Nandorroloco/SkyNando/WiFi version/pictures/IMG_20201117_204610 (957x1280).jpg

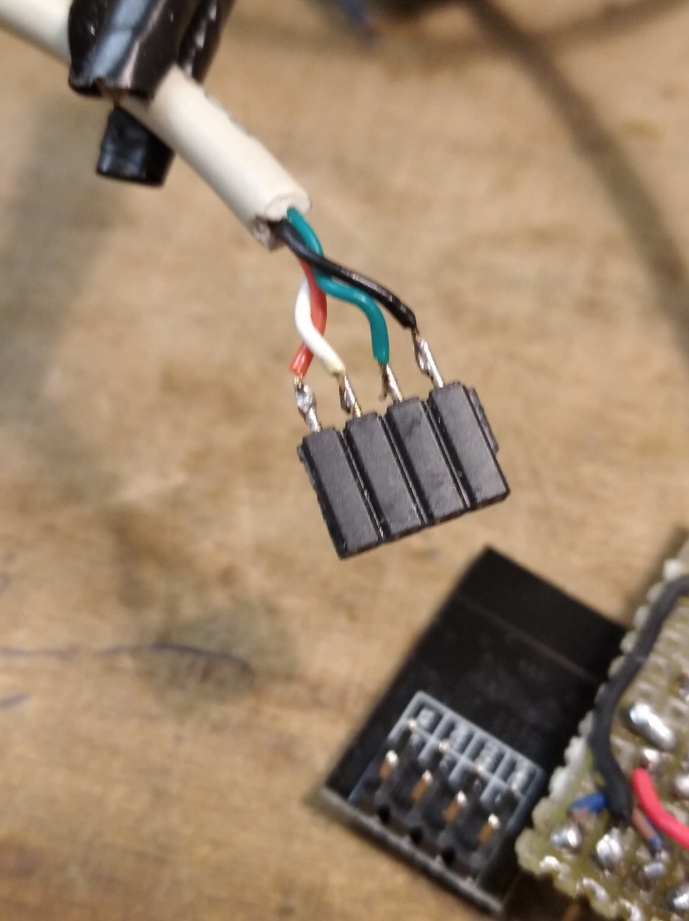
WiFi version/pictures/IMG_20201117_204610 (957x1280).jpg
