Nandorroloco/SkyNando/WiFi version/pictures/IMG_20201117_204422 (1280x957).jpg

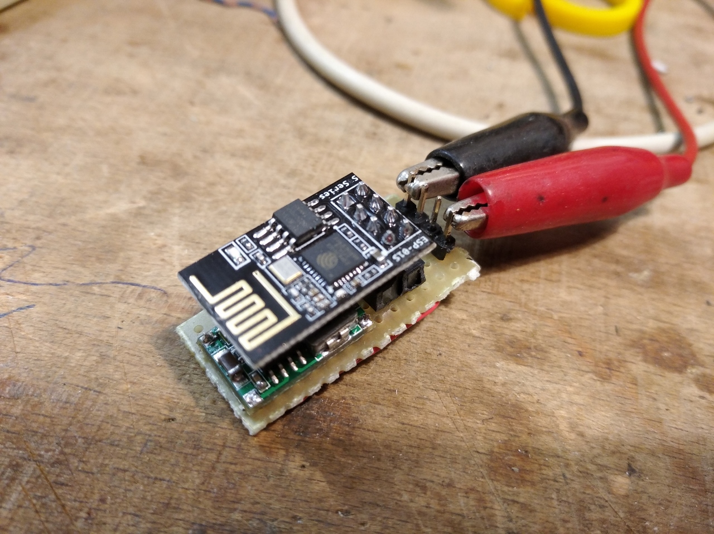
WiFi version/pictures/IMG_20201117_204422 (1280x957).jpg
