Nandorroloco/SkyNando/README.md

# SkyNando
Dongle for mount control SkyWatcher EQ6/HEQ5

Cheap dongle apdaptations working like EQDIR-BT or SynScan-Wifi

Contents:

"/SkyNando/BT version" It's an EQDIR-BT (bluethoot) equivalent

"/SkyNando/Wifi version" It's a SynScan-Wifi (Accespoint capable) equivalent

You will find in each directory documents, pictures, schematics, etc for assambly and programming these devices
