Nandorroloco/SkyNando/WiFi version/SkyNandoWifi_v1.pdf

# Electronics

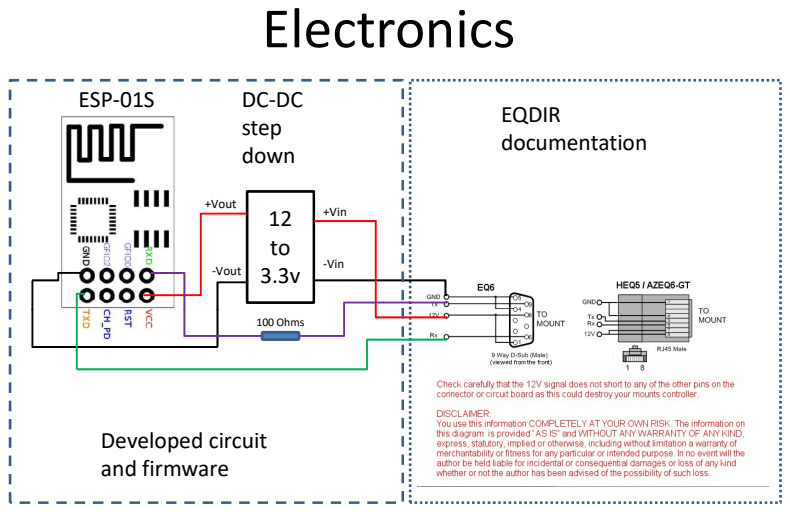
[picture p3: page 1]
-Vin; +Vin; -Vout; +Vout; ESP-01S; step down; EQDIR documentation; 100 Ohms; Developed circuit and firmware

# Communications context

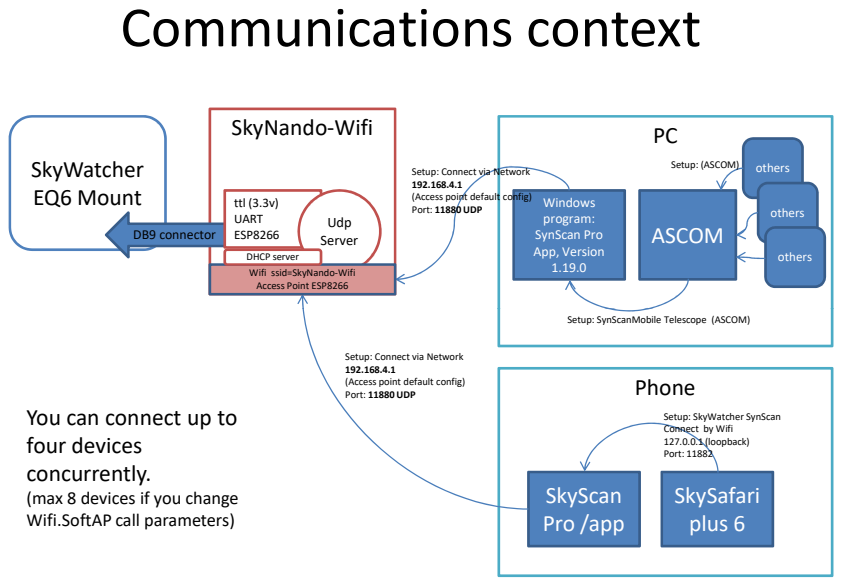
[picture p4: page 2]
SkyNando-Wifi; SkyWatcher EQ6 Mount; DB9 connector; Udp Server; Windows program: SynScan Pro App, Version 1.19.0; ASCOM; others; Setup: (ASCOM); Phone; SkyScan Pro /app

Setup: Connect via Network
(Access point default config)
Port: 11880 UDP

ttl (3.3v)
UART
ESP8266
DHCP server
Wifi ssid=SkyNando-Wifi
Access Point ESP8266

Setup: SynScanMobile Telescope (ASCOM)

You can connect up to
four devices
concurrently.
(max 8 devices if you change
Wifi.SoftAP call parameters)

Setup: SkyWatcher SynScan
Connect by Wifi
127.0.0.1 (loopback)
Port: 11882
SkySafari
plus 6

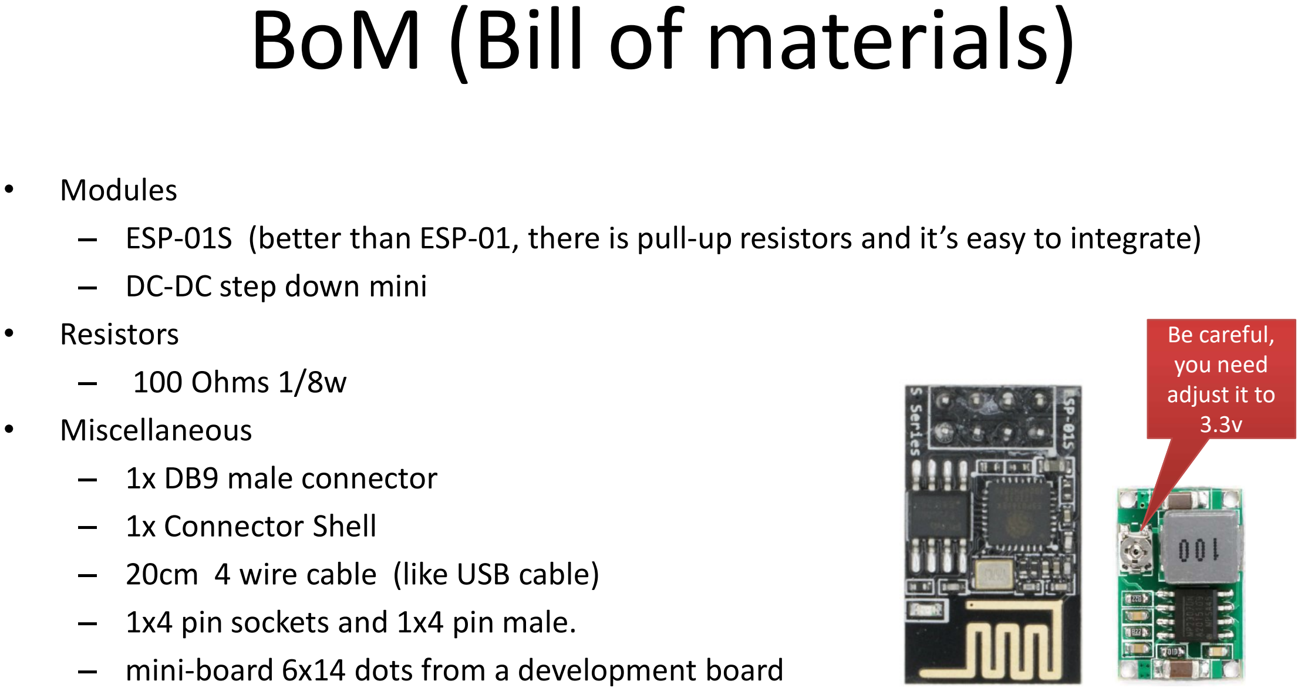
[picture p5: figure]
• Miscellaneous; Be careful, you need

BoM (Bill of materials) • | Modules – ESP-01S (better than ESP-01, there is pull-up resistors and it’s easy to integrate) – DC-DC step down mini • | Resistors – 100 Ohms 1/8w

adjust it to – 1x DB9 male connector – 1x Connector Shell – 20cm 4 wire cable (like USB cable) – 1x4 pin sockets and 1x4 pin male. – mini-board 6x14 dots from a development board

# Assembly instructions (1)

Follow the wiring diagram in Electronics page and build one device like this:

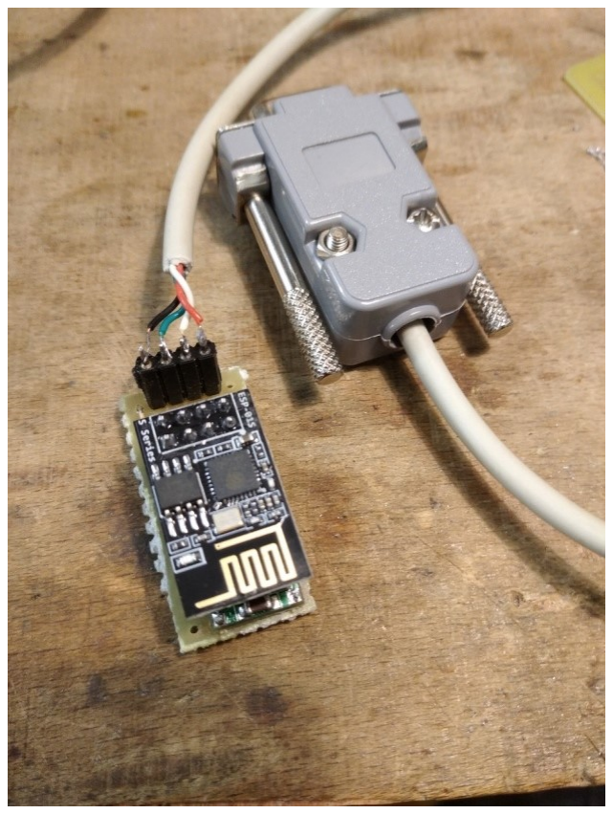
[picture p6: figure]

# Assembly instructions (2)

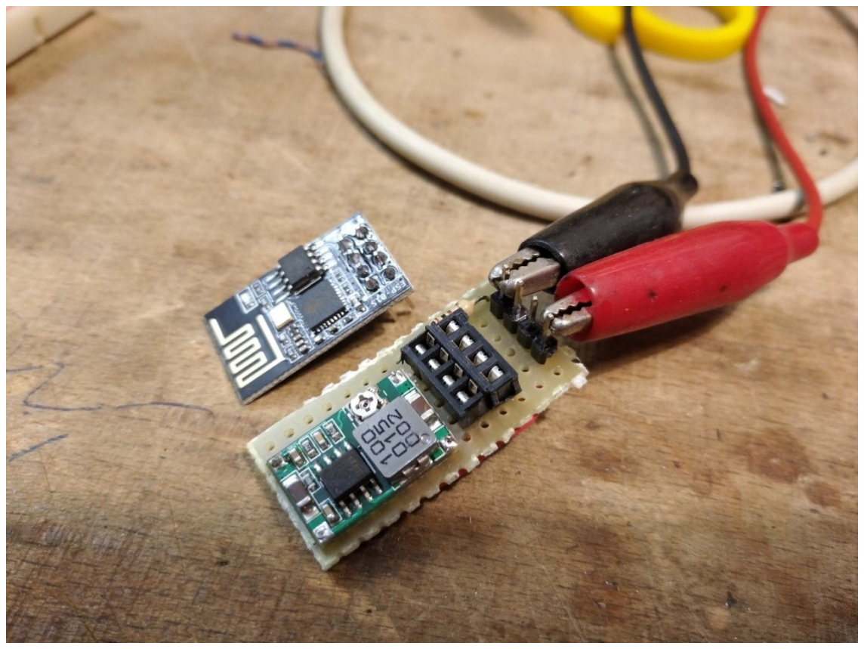
[picture p7: figure]

# Assembly instructions (3)

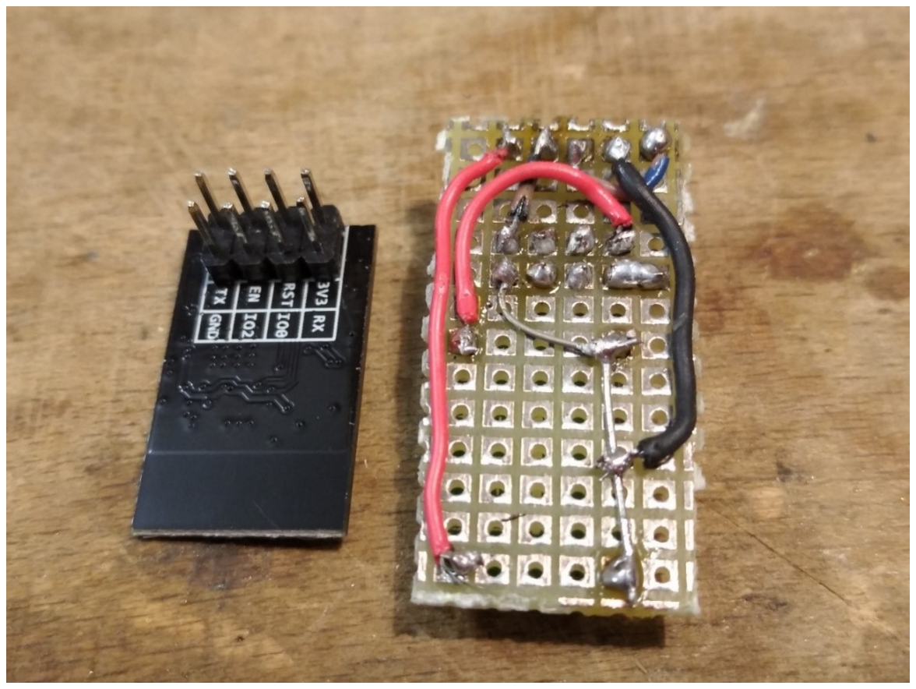
[picture p8: figure]

# Assembly instructions (4)

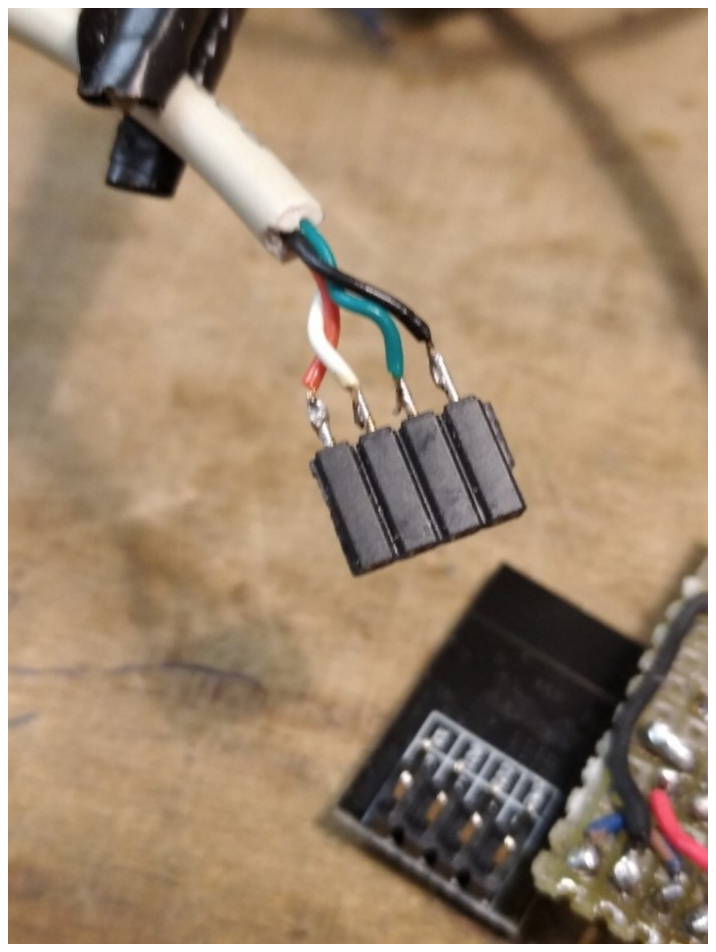
[picture p9: figure]
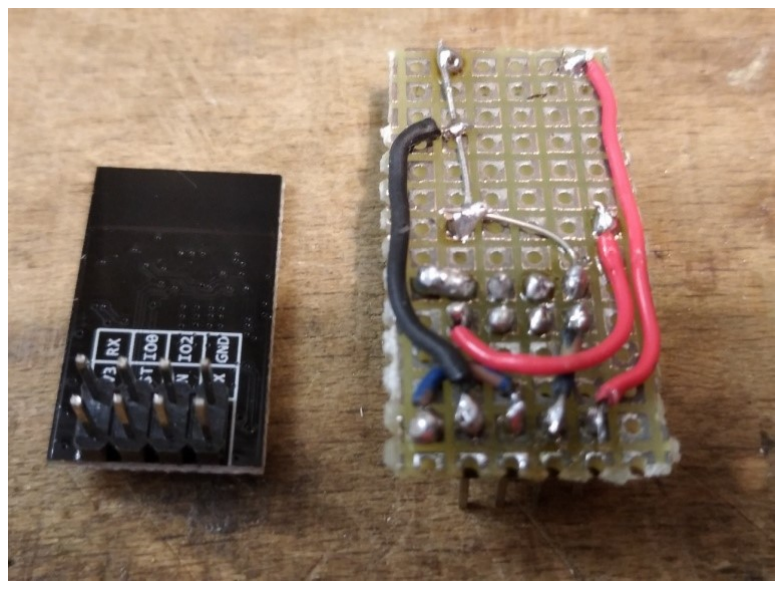
[picture p10: figure]

# HW Alternative

- You can build a device using the “Doit TTL-WiFi” item.

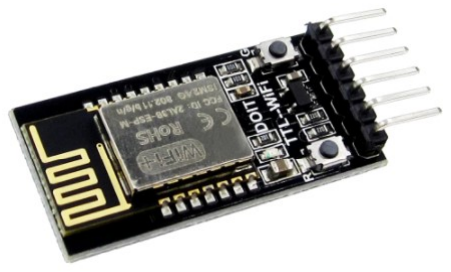
[picture p11: figure]

## - BoM

- Modules – ESP-01S (better than ESP-01, there is

pull-up resistors and it’s easy to integrate) – DC-DC step down mini • Resistors – 100 Ohms 1/8w

- Miscellaneous – 1x DB9 male connector – 1x Connector Shell – 20cm 4 wire cable (like USB cable) – 1x4 pin sockets and 1x4 pin male. – mini-board 6x14 dots from a

development board

# Electronics (2) VCC GND TXD RXD

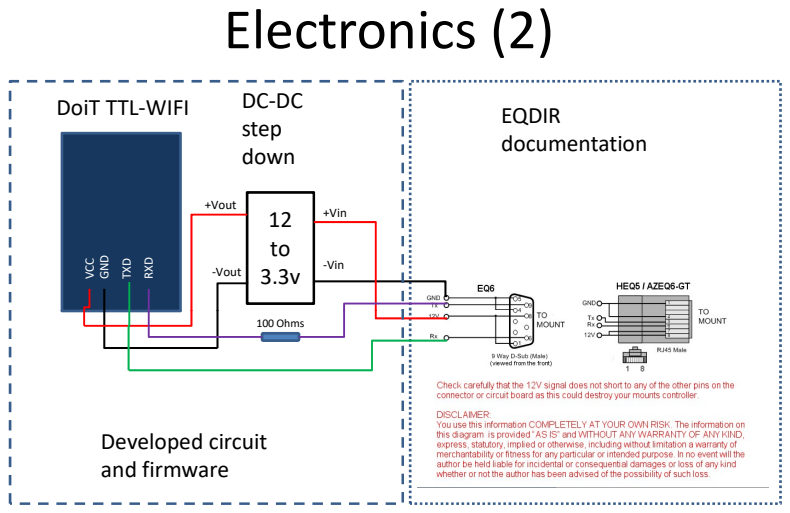
[picture p12: page 9]
-Vin; +Vin; -Vout; +Vout; DoiT TTL-WIFI; step down; EQDIR documentation; 100 Ohms; Developed circuit and firmware

# Configure Doit TTL-WiFi (1)

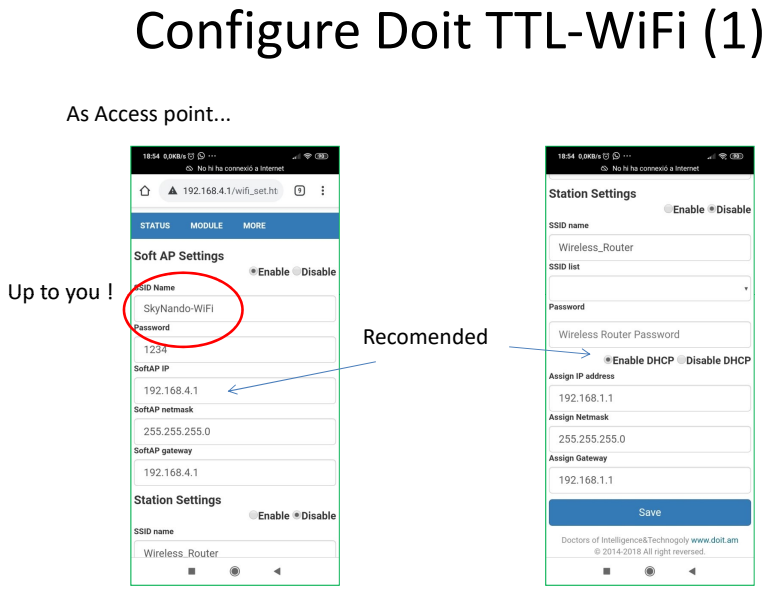
[picture p13: page 10]
Recomended

As Access point...

Up to you !

# Configure Doit TTL-WiFi ()

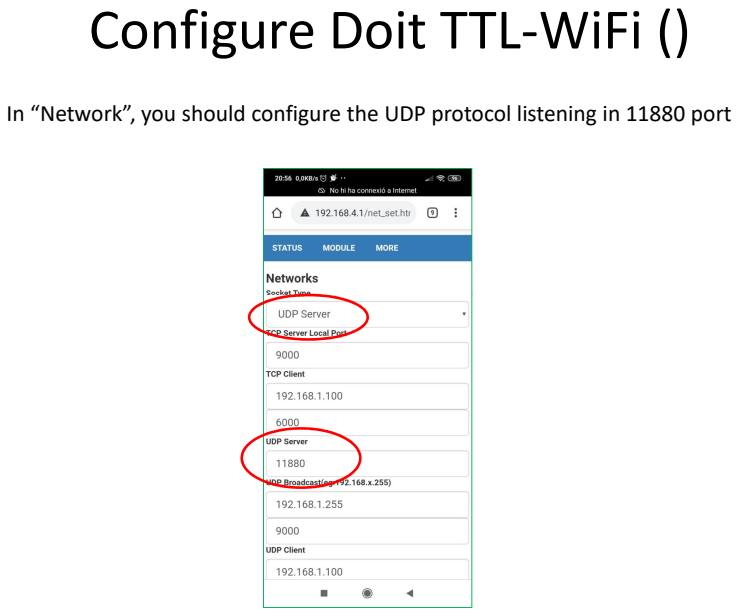
[picture p14: page 11]

In “Network”, you should configure the UDP protocol listening in 11880 port

# Configure Safari 6 plus app

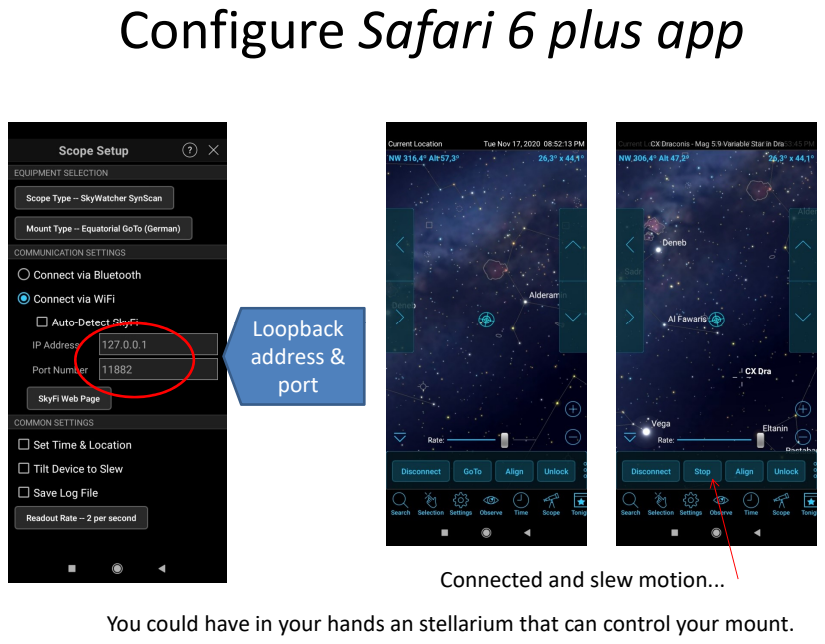
[picture p15: page 12]
address & port

Connected and slew motion...

You could have in your hands an stellarium that can control your mount.

# Comparative

Picture | ESP-01S | DoiT TTL-WiFi

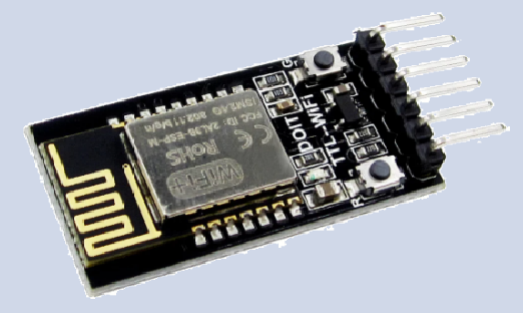
[picture p16: figure]
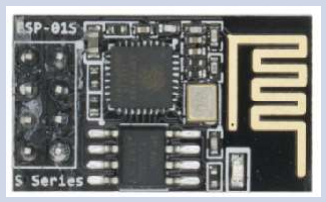
[picture p17: figure]

Cost | Cheapest under 1€ | Cheap unde 3€
Programing | Easy throught Arduino IDE (but not for novice) | You don’t need programming nothing, only configure
Integration | Easy | Easy
Advantages | Speed | Reset button, led indicator
Disadvantages | nothing | Some retrying packets in comms test

# Diagnostics

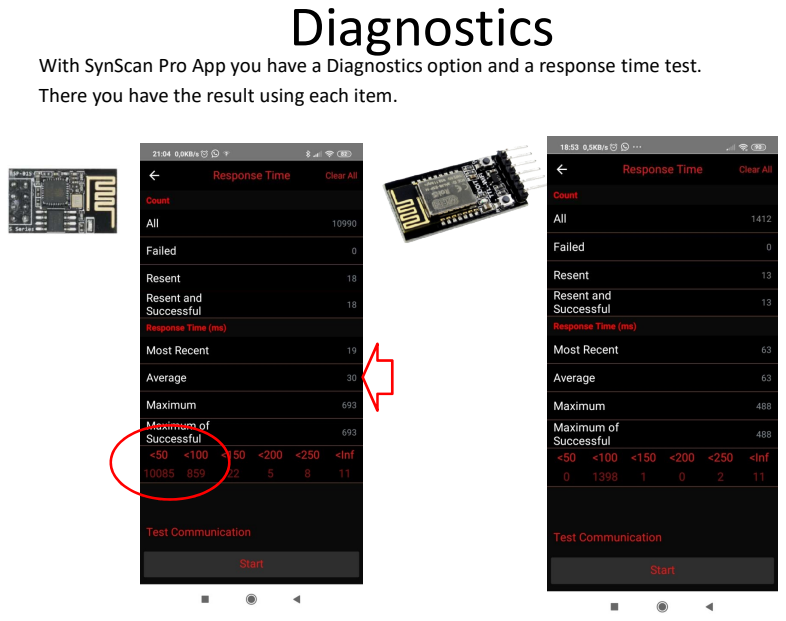
[picture p18: page 14]

With SynScan Pro App you have a Diagnostics option and a response time test.
There you have the result using each item.

Working...

## - SkyNando-Wifi (ESP-01s version) - https://www.youtube.com/watch?v=sFFKFTEkweU

SkyNando | version

## - https://www.youtube.com/watch?v=DeSCxQLQGFw

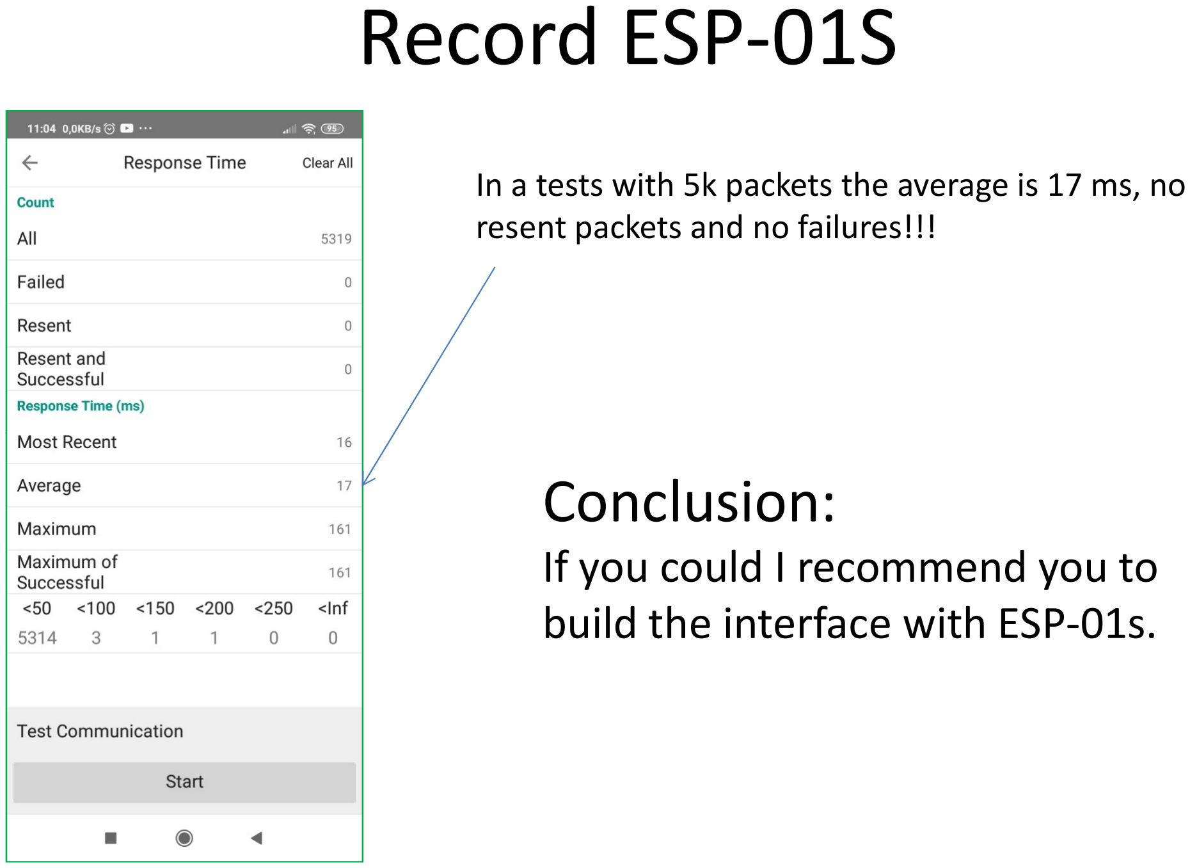
[picture p19: figure]
Record ESP-01S; resent packets and no failures!!!; Conclusion: If you could I recommend you to build the interface with ESP-01s.

In a tests with 5k packets the average is 17 ms, no
