Nandorroloco/SkyNando/BT version/IMG_20201109_192031_1 (1280x957).jpg

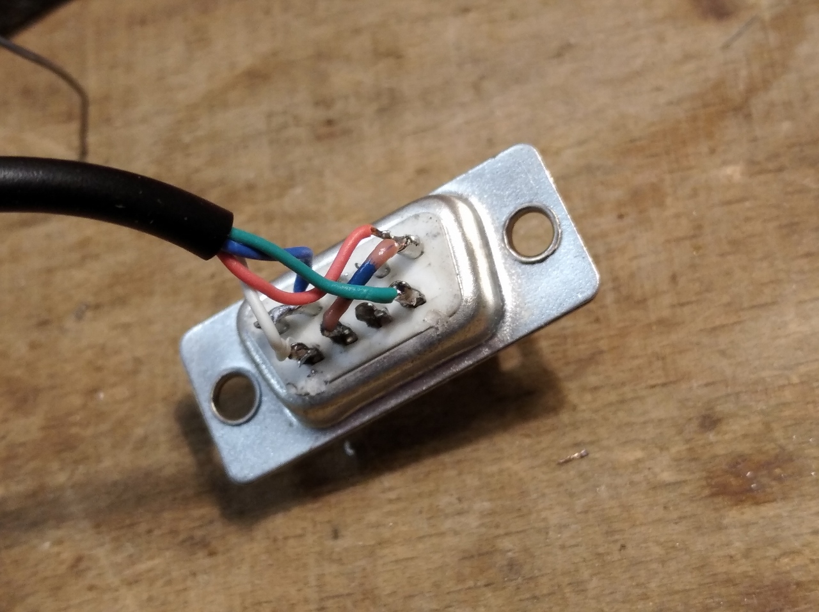
BT version/IMG_20201109_192031_1 (1280x957).jpg
