Nandorroloco/SkyNando/BT version/IMG_20201109_193238_1 (1280x957).jpg

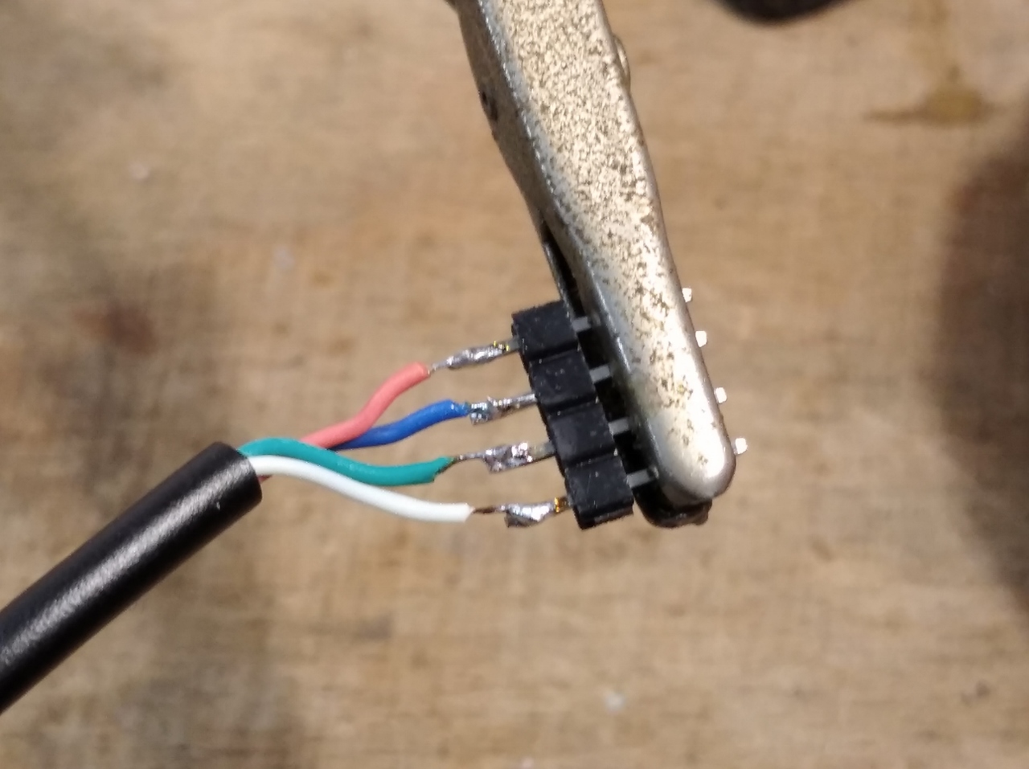
BT version/IMG_20201109_193238_1 (1280x957).jpg
