Nandorroloco/SkyNando/BT version/SkyNando-BT_wire.jpg

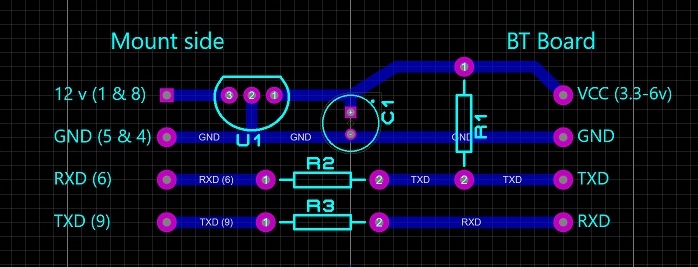
BT version/SkyNando-BT_wire.jpg
