Nandorroloco/SkyNando/WiFi version/pictures/IMG_20201117_204450 (1280x957).jpg

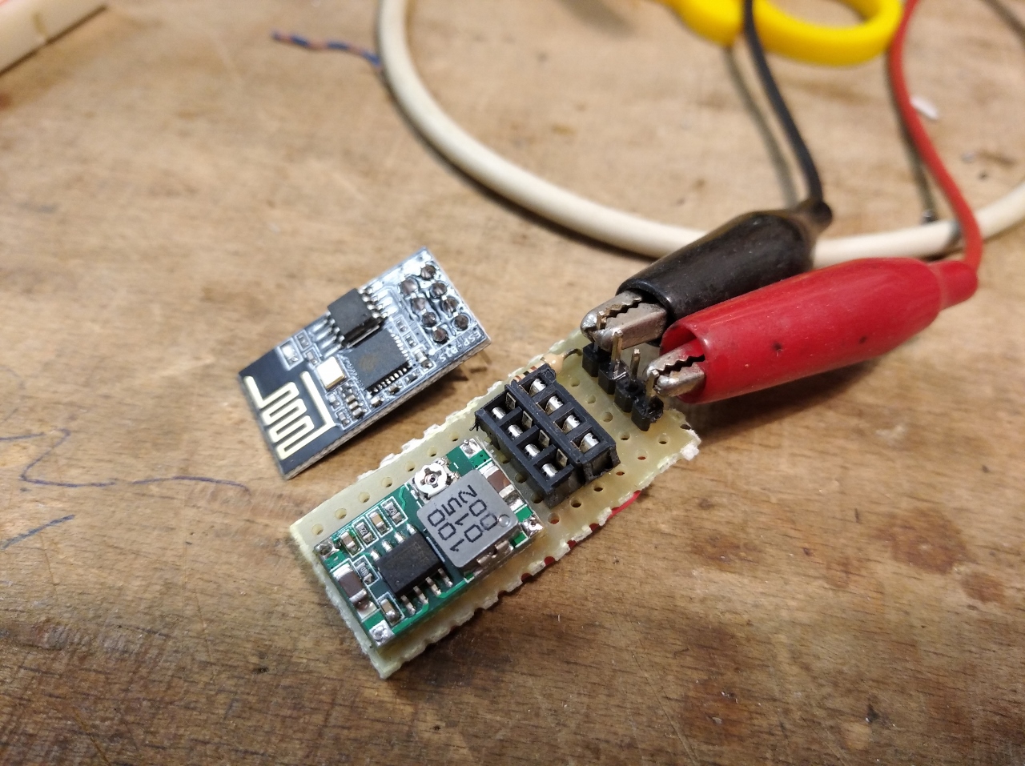
WiFi version/pictures/IMG_20201117_204450 (1280x957).jpg
