Nandorroloco/SkyNando/WiFi version/pictures/IMG_20201117_204701_1 (957x1280).jpg

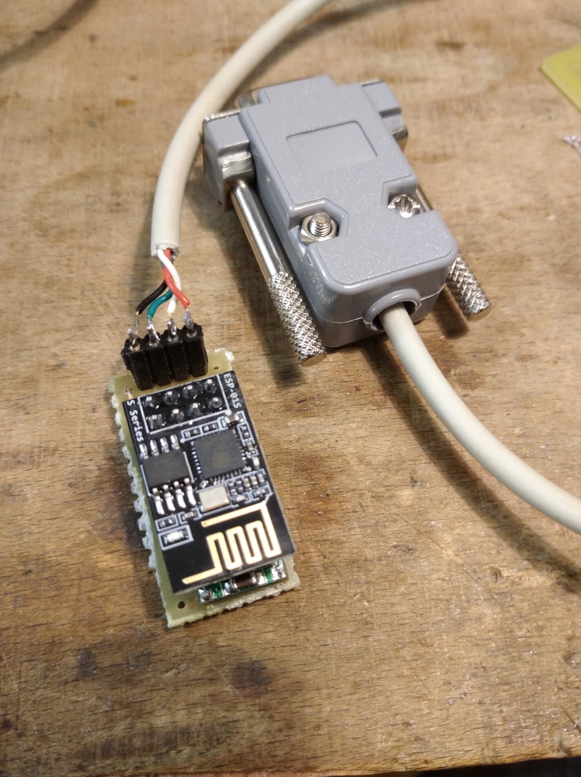
WiFi version/pictures/IMG_20201117_204701_1 (957x1280).jpg
