Nandorroloco/SkyNando/BT version/Schema_SkyNandoUSB.pdf

U1

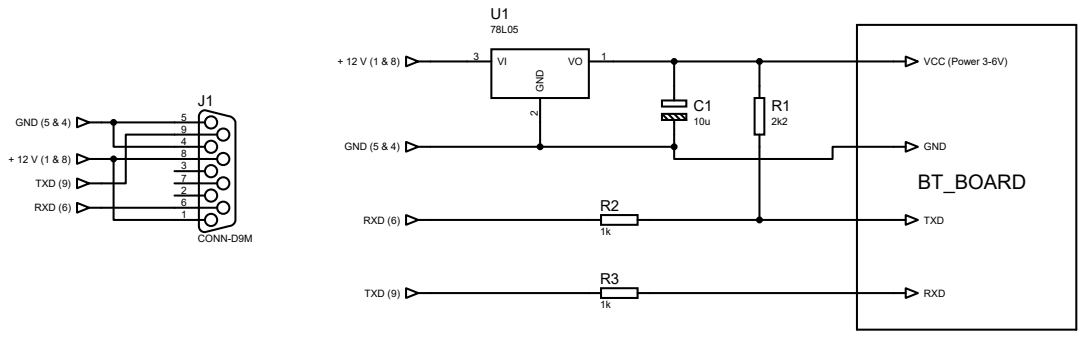
[picture p30: page 1]
DATE:; PAGE:; SkyNandoUSB.pdsprj; @AUTHOR; 9 PATH:; C:\Users\Nando\Documents\Proteus\SynScanWIFI\SkyNandoUSB.pdsprj 1 of 1; REV:@REV; TIME:; CONN-D9M; GND (5 & 4); TXD (9); RXD (6); 1 GND; VCC (Power 3-6V); GND; TXD; RXD; BT_BOARD

FILE NAME:
DESIGN TITLE: SkyNandoUSB.pdsprj
